vsu/weather-station-receiver/android/ic_launcher-web.png

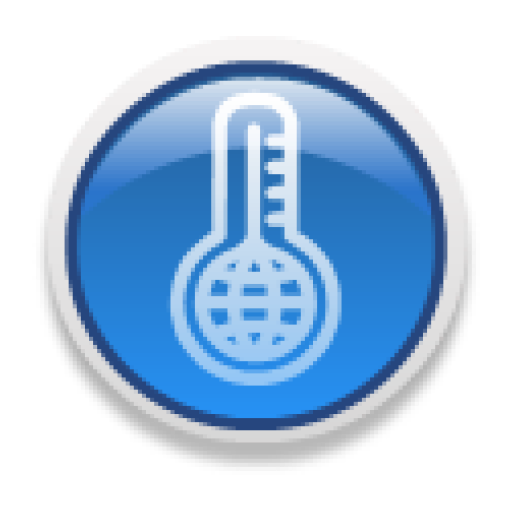
android/ic_launcher-web.png
