vsu/weather-station-receiver/hardware/weather.pdf

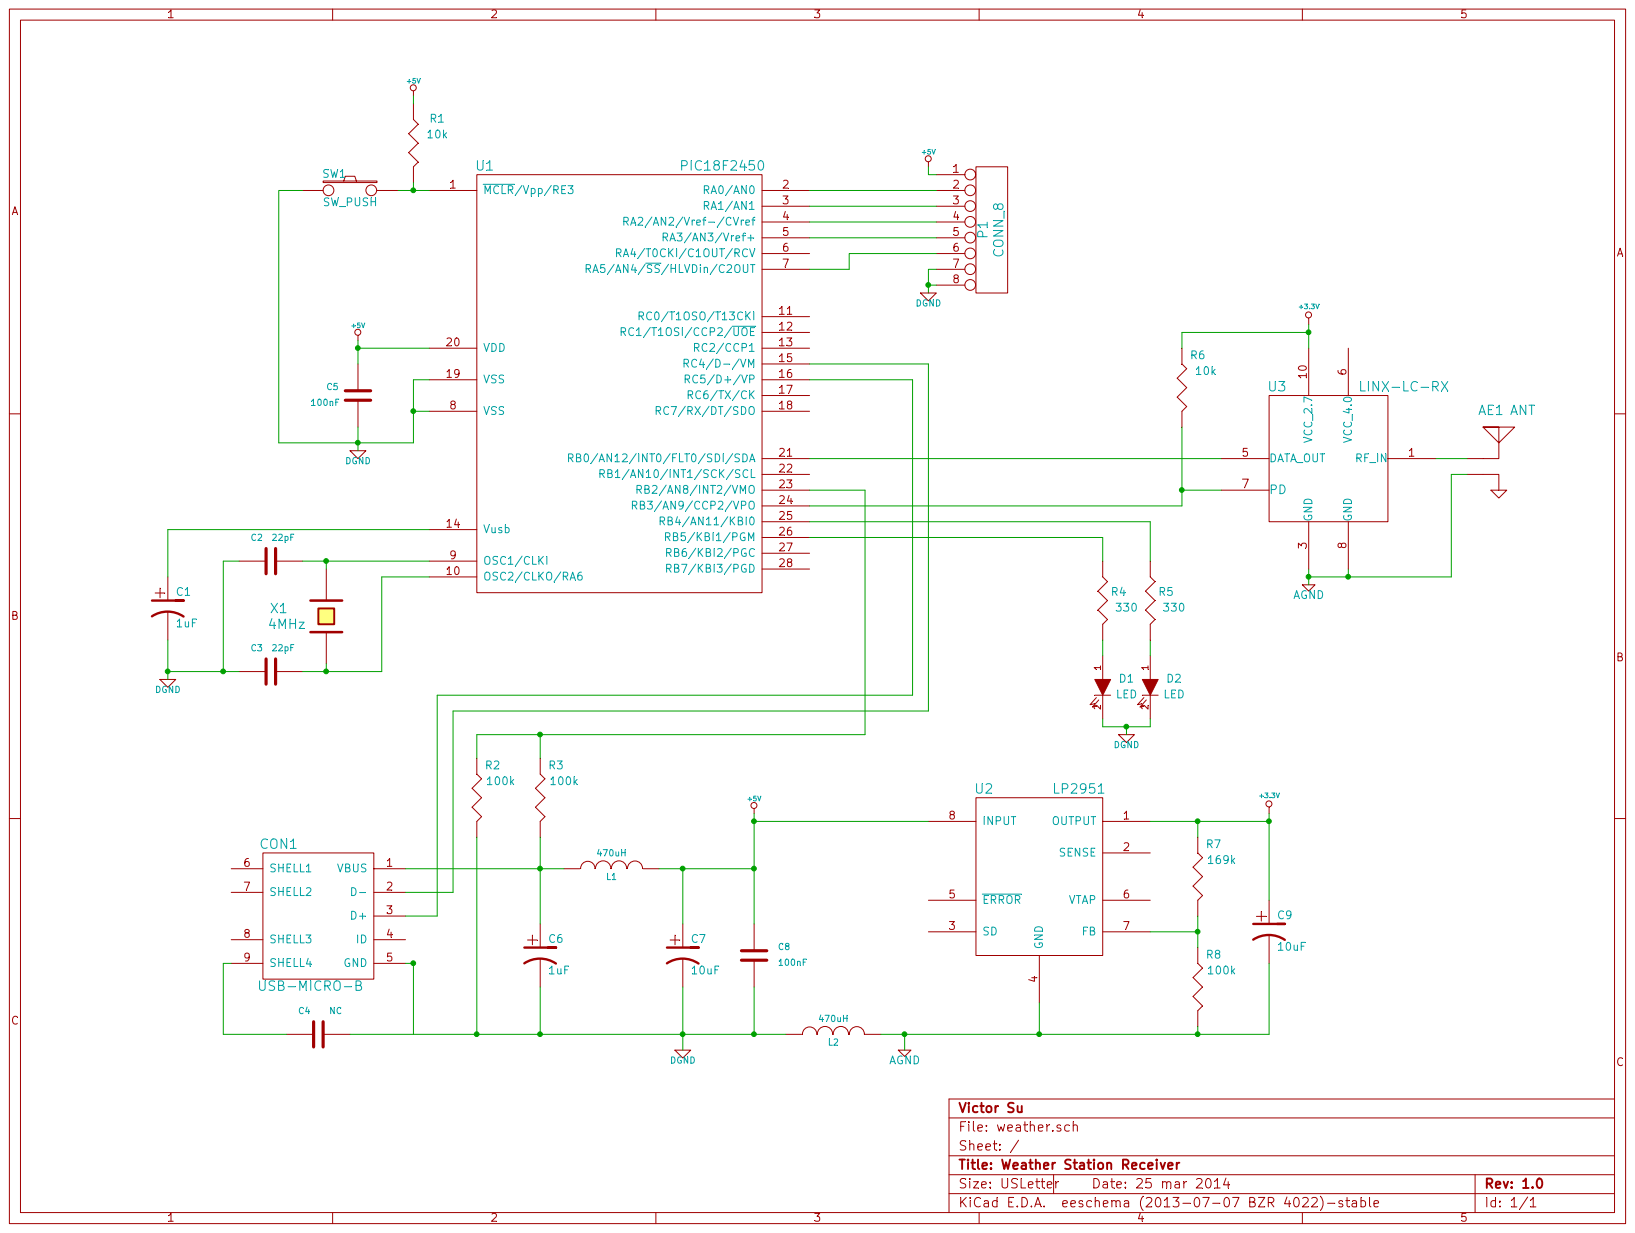
[picture p2: page 1]
