vsu/weather-station-receiver/hardware/weather.sch

## KiCad design hardware/weather.sch (2014-03-25)

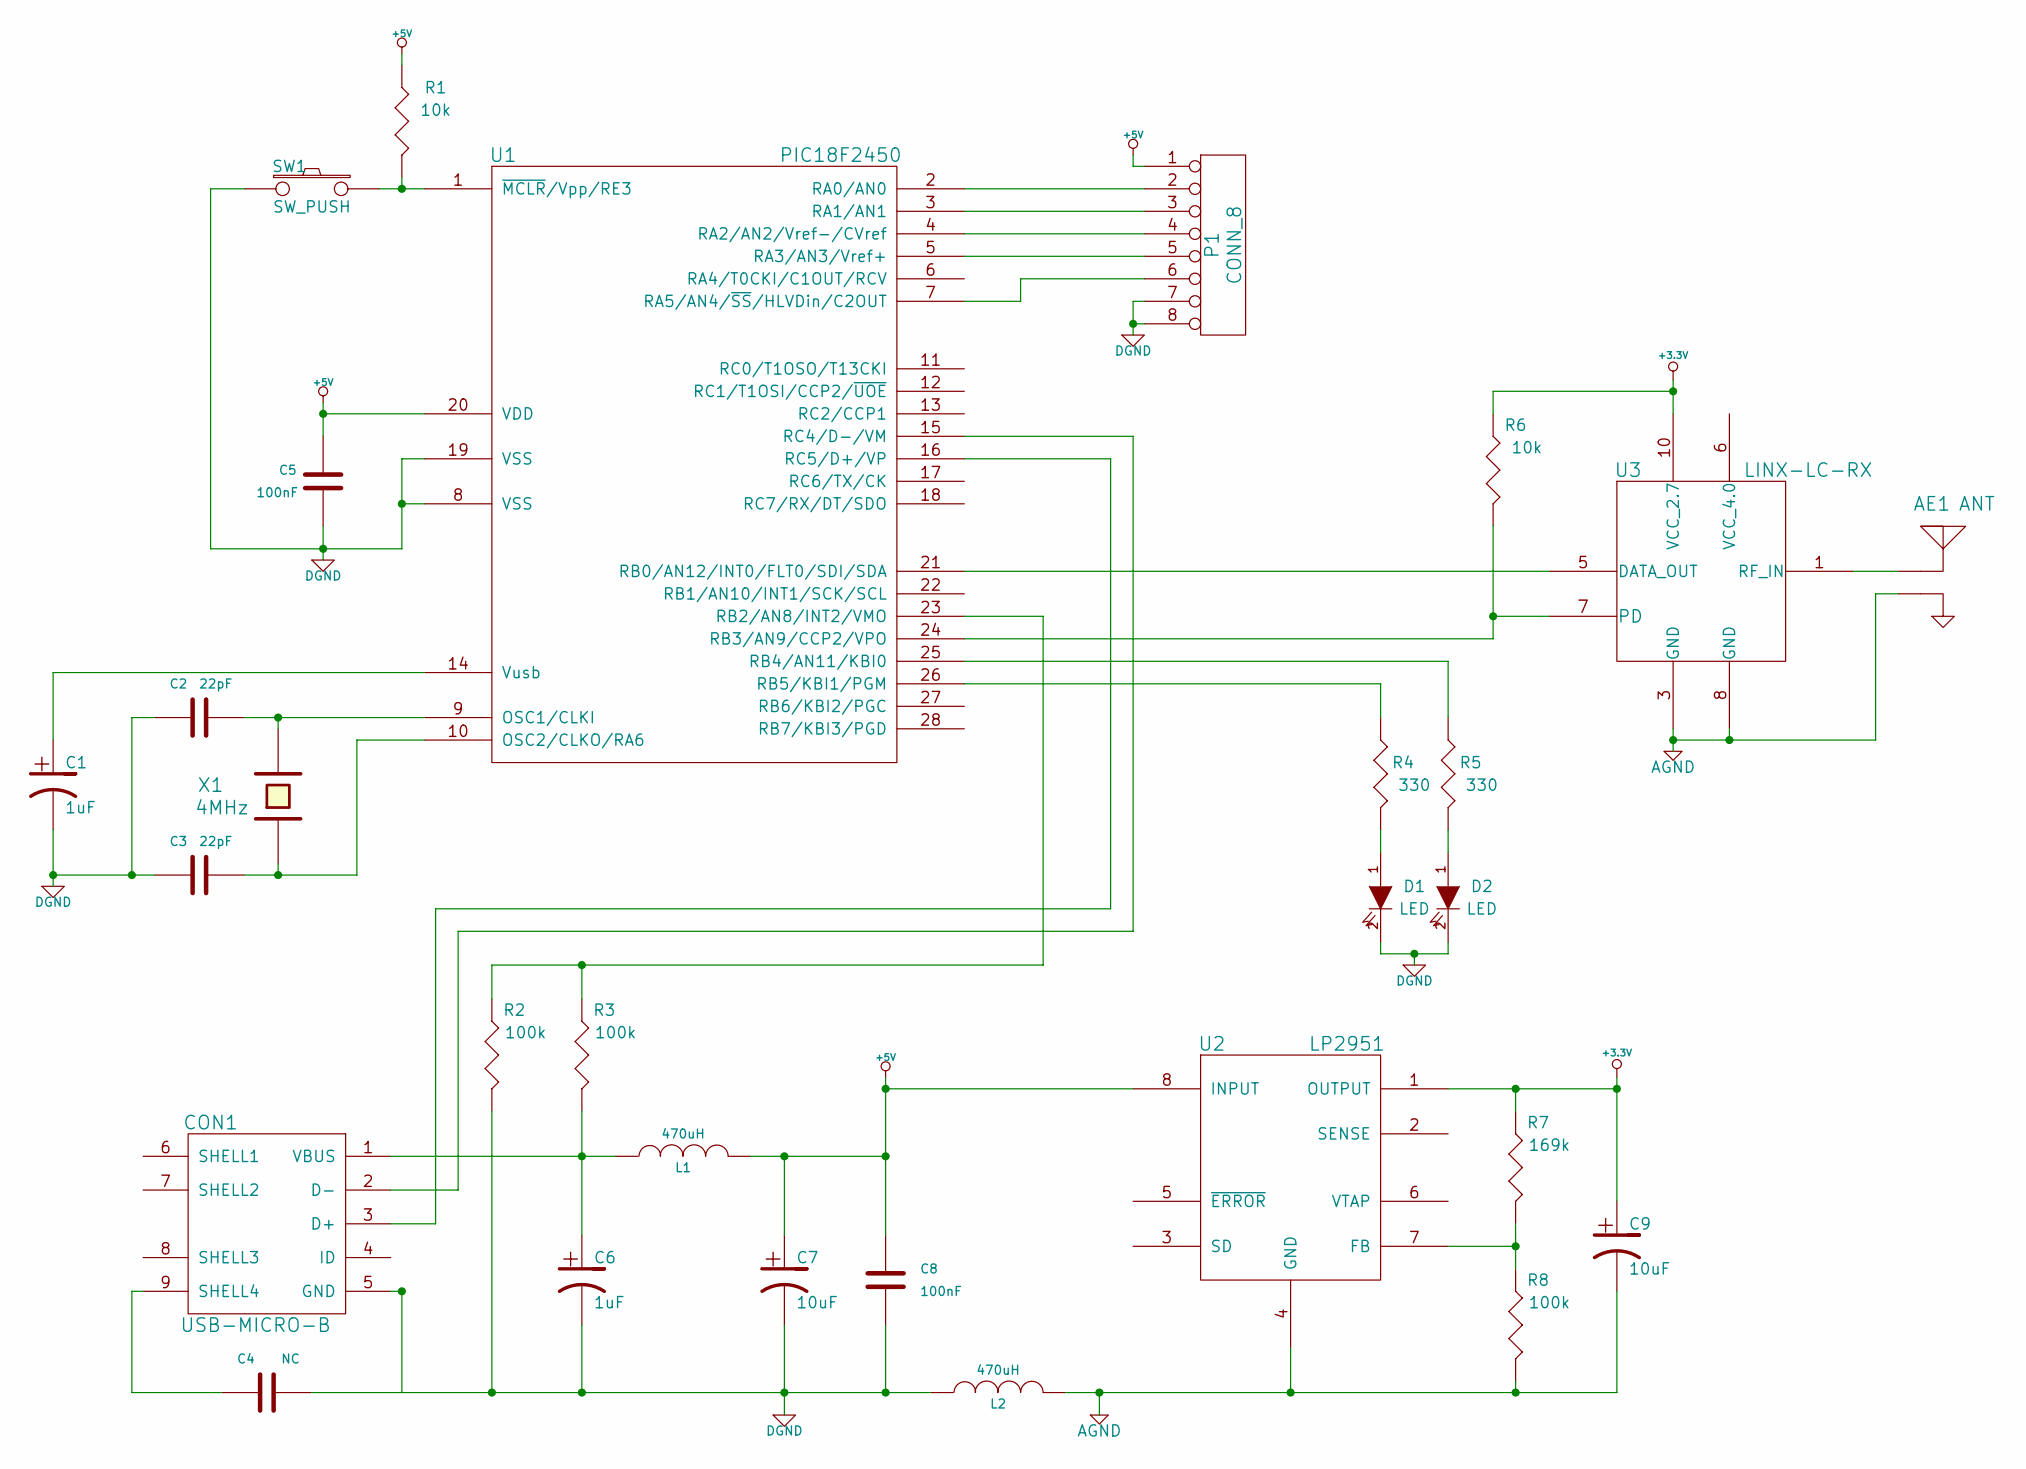
[picture p3: schematic weather.sch]

Parts:
AE1: ANT
C1, C6: 1uF
C2, C3: 22pF
C4: NC
C5, C8: 100nF
C7, C9: 10uF
CON1: USB-MICRO-B
D1, D2: LED
L1, L2: 470uH
P1: CONN_8
R1, R6: 10k
R2, R3, R8: 100k
R4, R5: 330
R7: 169k
SW1: SW_PUSH
U1: PIC18F2450
U2: LP2951
U3: LINX-LC-RX
X1: 4MHz

Connections:
+3.3V: C9.1, R6.1, R7.1, U2.1 (OUTPUT), U3.10 (VCC_2.7)
+5V: C5.1, C7.1, C8.1, L1.2, P1.1, R1.1, U1.20 (VDD), U2.8 (INPUT)
AGND: AE1.2 (GND), C9.2, L2.2, R8.2, U2.4 (GND), U3.3 (GND), U3.8 (GND)
DGND: C1.2, C2.1, C3.1, C4.2, C5.2, C6.2, C7.2, C8.2, D1.2 (K), D2.2 (K), L2.1, P1.7, P1.8, R2.2, SW1.1, U1.8 (VSS), U1.19 (VSS)
unnamed: AE1.1 (SIG), U3.1 (RF_IN)
unnamed: C1.1, U1.14 (Vusb)
unnamed: C2.2, U1.9 (OSC1/CLKI), X1.2
unnamed: C3.2, U1.10 (OSC2/CLKO/RA6), X1.1
unnamed: C4.1, CON1.9 (SHELL4)
unnamed: C6.1, CON1.1 (VBUS), L1.1, R3.2
unnamed: CON1.2 (D-), U1.15 (RC4/D-/VM)
unnamed: CON1.3 (D+), U1.16 (RC5/D+/VP)
unnamed: D1.1 (A), R4.2
unnamed: D2.1 (A), R5.2
unnamed: P1.2, U1.2 (RA0/AN0)
unnamed: P1.3, U1.3 (RA1/AN1)
unnamed: P1.4, U1.4 (RA2/AN2/Vref-/CVref)
unnamed: P1.5, U1.5 (RA3/AN3/Vref+)
unnamed: P1.6, U1.7 (RA5/AN4/~SS~/HLVDin/C2OUT)
unnamed: R1.2, SW1.2, U1.1 (~MCLR~/Vpp/RE3)
unnamed: R2.1, R3.1, U1.23 (RB2/AN8/INT2/VMO)
unnamed: R4.1, U1.26 (RB5/KBI1/PGM)
unnamed: R5.1, U1.25 (RB4/AN11/KBI0)
unnamed: R6.2, U1.24 (RB3/AN9/CCP2/VPO), U3.7 (PD)
unnamed: R7.2, R8.1, U2.7 (FB)
unnamed: U1.21 (RB0/AN12/INT0/FLT0/SDI/SDA), U3.5 (DATA_OUT)
