vsu/weather-station-receiver/(commit log)

2014-03-25 Load boostrap and jquery from CDN
    Add thread synchronization to listeners map
2014-04-05 Fix reset button alignment
2014-04-06 Fix issue of duplicated history data
    Move sensor received data processing from listener to sensor instance. This caused duplicated history data because each websocket client would create a new listener instance.
2014-04-09 Fix issues with hanging listeners
    Remove listeners when send operation fails. Send proper websocket close frame in web and android apps.
